nicholasrighi/3D_Printer_Board/README.md

# 3D_Printer_Board

Circuit board layout for 3D printer control board and partial 3D printer control code.
