nicholasrighi/3D_Printer_Board/Driver_board.kicad_pcb

## KiCad design Driver_board.kicad_pcb (2020-10-23)

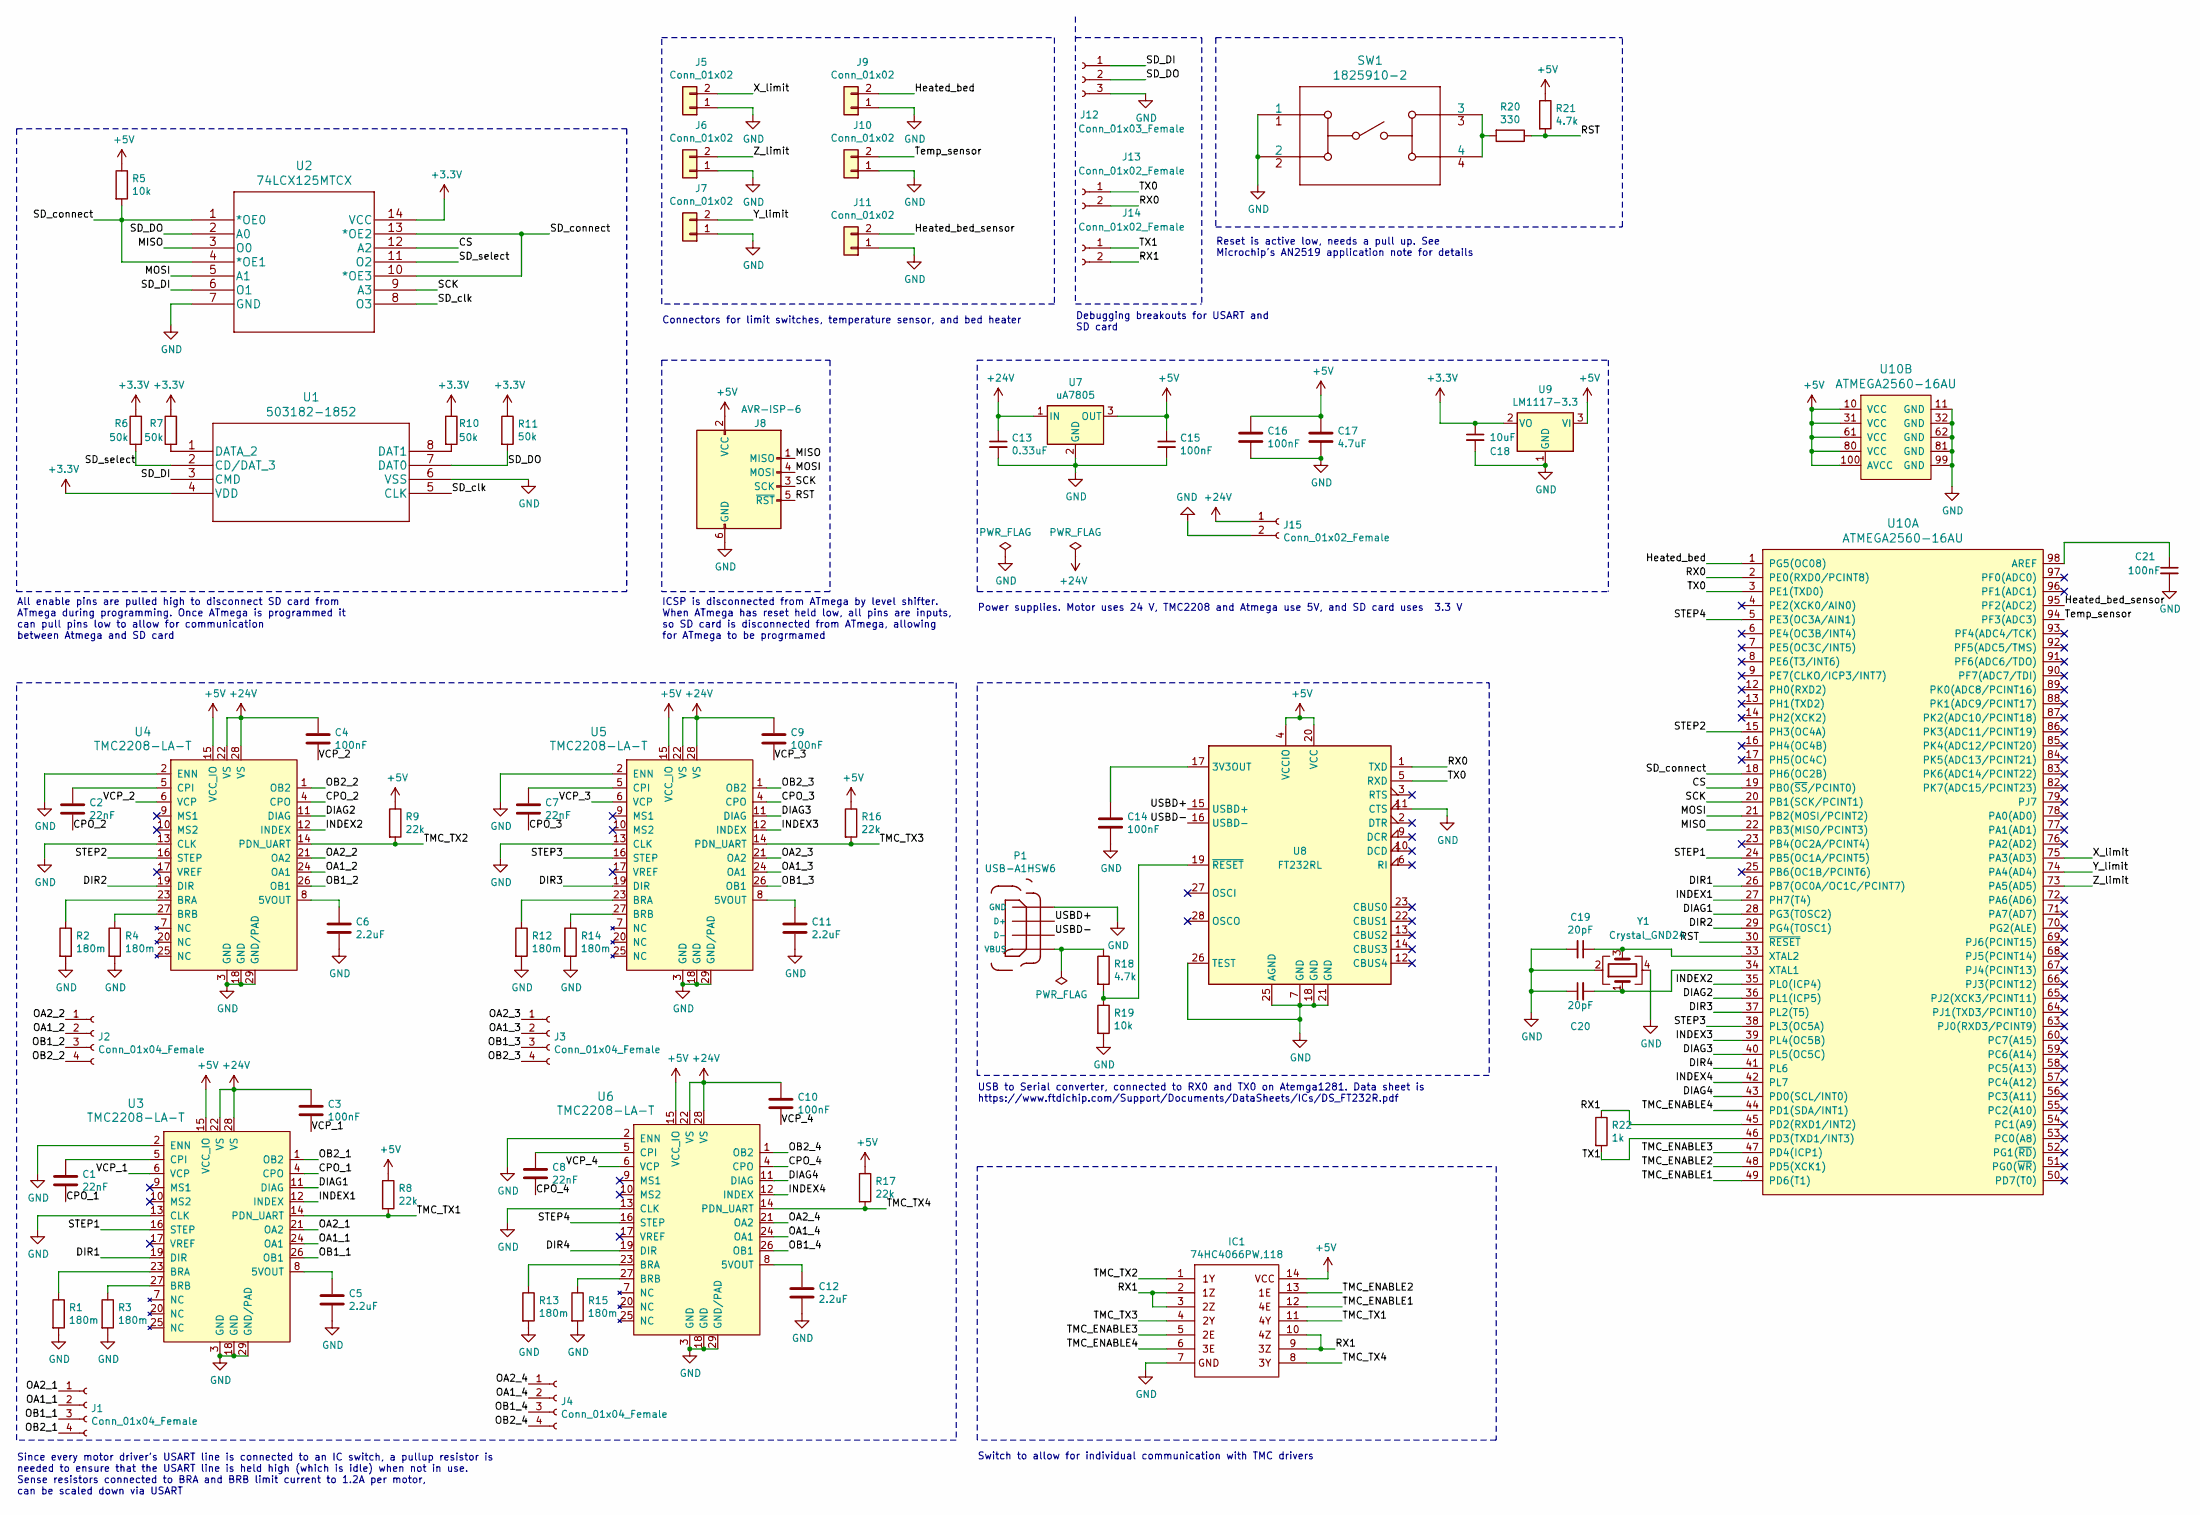
[picture p1: schematic Driver_board.sch]

Parts:
C1, C2, C7, C8: 22nF; C_0805_2012Metric_Pad1.15x1.40mm_HandSolder
C3, C4, C9, C10, C14, C21: 100nF; C_0805_2012Metric_Pad1.15x1.40mm_HandSolder
C5, C6, C11, C12: 2.2uF; C_0805_2012Metric_Pad1.15x1.40mm_HandSolder
C13: 0.33uF; alum_electro_cap
C15, C16: 100nF; alum_electro_cap
C17: 4.7uF; alum_electro_cap
C18: 10uF; alum_electro_cap
C19, C20: 20pF; C_0805_2012Metric_Pad1.15x1.40mm_HandSolder
IC1: 74HC4066PW,118; SOP65P640X110-14N; Manufacturer_Part_Number 74HC4066PW,118; Mouser Part Number 771-74HC4066PW-T
J1, J2, J3, J4: Conn_01x04_Female; PinHeader_1x04_P2.54mm_Vertical
J5, J6, J7, J9, J10, J11: Conn_01x02; PinHeader_1x02_P2.54mm_Vertical
J8: AVR-ISP-6; PinHeader_2x03_P2.54mm_Vertical
J12: Conn_01x03_Female; PinHeader_1x03_P2.54mm_Vertical
J13, J14: Conn_01x02_Female; PinSocket_1x02_P2.54mm_Vertical
J15: Conn_01x02_Female; 282837-2_power_connector
P1: USB-A1HSW6; OST_USB-A1HSW6
R1, R2, R3, R4, R12, R13, R14, R15: 180m; R_0805_2012Metric_Pad1.15x1.40mm_HandSolder
R5, R19: 10k; R_0805_2012Metric_Pad1.15x1.40mm_HandSolder
R6, R7, R10, R11: 50k; R_0805_2012Metric_Pad1.15x1.40mm_HandSolder
R8, R9, R16, R17: 22k; R_0805_2012Metric_Pad1.15x1.40mm_HandSolder
R18, R21: 4.7k; R_0805_2012Metric_Pad1.15x1.40mm_HandSolder
R20: 330; R_0805_2012Metric_Pad1.15x1.40mm_HandSolder
R22: 1k; R_0805_2012Metric_Pad1.15x1.40mm_HandSolder
SW1: 1825910-2; 1825910-2_pushbutton
U1: 503182-1852
U2: 74LCX125MTCX
U3, U4, U5, U6: TMC2208-LA-T; VFQFN-28-1EP_5x5mm; MPN TMC2208-LA-T; Digi-Key_PN 1460-1184-1-ND
U7: uA7805; UA7805CKTTR
U8: FT232RL; SSOP-28_5.3x10.2mm_P0.65mm
U9: LM1117-3.3; LM1117IMP-3.3&slash_NOPB
U10: ATMEGA2560-16AU; TQFP-100_14x14mm; MPN ATMEGA2560-16AU; Digi-Key_PN ATMEGA2560-16AU-ND
Y1: Crystal_GND24; Crystal_SMD_3225-4Pin_3.2x2.5mm

Connections:
+3V3: C18.1, R6.1, R7.1, R10.1, R11.1, U1.4 (VDD), U2.14 (VCC), U9.2 (VO)
+5V: C15.1, C16.1, C17.1, IC1.14, J8.2 (VCC), R5.1, R8.1, R9.1, R16.1, R17.1, R21.1, U3.15 (VCC_IO), U4.15 (VCC_IO), U5.15 (VCC_IO), U6.15 (VCC_IO), U7.3 (OUT), U8.4 (VCCIO), U8.20 (VCC), U9.3 (VI), U10.10 (VCC), U10.31 (VCC), U10.61 (VCC), U10.80 (VCC), U10.100 (AVCC)
+24V: C3.1, C4.1, C9.1, C10.1, C13.1, J15.1, U3.22 (VS), U3.28 (VS), U4.22 (VS), U4.28 (VS), U5.22 (VS), U5.28 (VS), U6.22 (VS), U6.28 (VS), U7.1 (IN)
/CPO_1: C1.2, U3.4 (CPO)
/CPO_2: C2.2, U4.4 (CPO)
/CPO_3: C7.2, U5.4 (CPO)
/CPO_4: C8.2, U6.4 (CPO)
/CS: U2.12 (A2), U10.19 (PB0(~SS~/PCINT0))
/DIAG1: U3.11 (DIAG), U10.28 (PG3(TOSC2))
/DIAG2: U4.11 (DIAG), U10.36 (PL1(ICP5))
/DIAG3: U5.11 (DIAG), U10.40 (PL5(OC5C))
/DIAG4: U6.11 (DIAG), U10.43 (PD0(SCL/INT0))
/DIR1: U3.19 (DIR), U10.26 (PB7(OC0A/OC1C/PCINT7))
/DIR2: U4.19 (DIR), U10.29 (PG4(TOSC1))
/DIR3: U5.19 (DIR), U10.37 (PL2(T5))
/DIR4: U6.19 (DIR), U10.41 (PL6)
/Heated_bed: J9.2, U10.1 (PG5(OC08))
/Heated_bed_sensor: J11.2, U10.95 (PF2(ADC2))
/INDEX1: U3.12 (INDEX), U10.27 (PH7(T4))
/INDEX2: U4.12 (INDEX), U10.35 (PL0(ICP4))
/INDEX3: U5.12 (INDEX), U10.39 (PL4(OC5B))
/INDEX4: U6.12 (INDEX), U10.42 (PL7)
/MISO: J8.1 (MISO), U2.3 (O0), U10.22 (PB3(MISO/PCINT3))
/MOSI: J8.4 (MOSI), U2.5 (A1), U10.21 (PB2(MOSI/PCINT2))
/OA1_1: J1.2, U3.24 (OA1)
/OA1_2: J2.2, U4.24 (OA1)
/OA1_3: J3.2, U5.24 (OA1)
/OA1_4: J4.2, U6.24 (OA1)
/OA2_1: J1.1, U3.21 (OA2)
/OA2_2: J2.1, U4.21 (OA2)
/OA2_3: J3.1, U5.21 (OA2)
/OA2_4: J4.1, U6.21 (OA2)
/OB1_1: J1.3, U3.26 (OB1)
/OB1_2: J2.3, U4.26 (OB1)
/OB1_3: J3.3, U5.26 (OB1)
/OB1_4: J4.3, U6.26 (OB1)
/OB2_1: J1.4, U3.1 (OB2)
/OB2_2: J2.4, U4.1 (OB2)
/OB2_3: J3.4, U5.1 (OB2)
/OB2_4: J4.4, U6.1 (OB2)
/RST: J8.5 (~RST), R20.1, R21.2, U10.30 (~RESET)
/RX0: J13.2, U8.1 (TXD), U10.2 (PE0(RXD0/PCINT8))
/RX1: IC1.2, IC1.3, IC1.9, IC1.10, J14.2, R22.1, U10.45 (PD2(RXD1/INT2))
/SCK: J8.3 (SCK), U2.9 (A3), U10.20 (PB1(SCK/PCINT1))
/SD_DI: J12.1, U1.3 (CMD), U2.6 (O1)
/SD_DO: J12.2, R11.2, U1.7 (DAT0), U2.2 (A0)
/SD_clk: U1.5 (CLK), U2.8 (O3)
/SD_connect: R5.2, U2.1 (*OE0), U2.4 (*OE1), U2.10 (*OE3), U2.13 (*OE2), U10.18 (PH6(OC2B))
/SD_select: R6.2, U1.2 (CD/DAT_3), U2.11 (O2)
/STEP1: U3.16 (STEP), U10.24 (PB5(OC1A/PCINT5))
/STEP2: U4.16 (STEP), U10.15 (PH3(OC4A))
/STEP3: U5.16 (STEP), U10.38 (PL3(OC5A))
/STEP4: U6.16 (STEP), U10.5 (PE3(OC3A/AIN1))
/TMC_ENABLE1: IC1.12, U10.49 (PD6(T1))
/TMC_ENABLE2: IC1.13, U10.48 (PD5(XCK1))
/TMC_ENABLE3: IC1.5, U10.47 (PD4(ICP1))
/TMC_ENABLE4: IC1.6, U10.44 (PD1(SDA/INT1))
/TMC_TX1: IC1.11, R8.2, U3.14 (PDN_UART)
/TMC_TX2: IC1.1, R9.2, U4.14 (PDN_UART)
/TMC_TX3: IC1.4, R16.2, U5.14 (PDN_UART)
/TMC_TX4: IC1.8, R17.2, U6.14 (PDN_UART)
/TX0: J13.1, U8.5 (RXD), U10.3 (PE1(TXD0))
/TX1: J14.1, R22.2, U10.46 (PD3(TXD1/INT3))
/Temp_sensor: J10.2, U10.94 (PF3(ADC3))
/USBD+: P1.3 (D+), U8.15 (USBD+)
/USBD-: P1.2 (D-), U8.16 (USBD-)
/VCP_1: C3.2, U3.6 (VCP)
/VCP_2: C4.2, U4.6 (VCP)
/VCP_3: C9.2, U5.6 (VCP)
/VCP_4: C10.2, U6.6 (VCP)
/X_limit: J5.2, U10.75 (PA3(AD3))
/Y_limit: J7.2, U10.74 (PA4(AD4))
/Z_limit: J6.2, U10.73 (PA5(AD5))
GND: C5.2, C6.2, C11.2, C12.2, C13.2, C14.2, C15.2, C16.2, C17.2, C18.2, C19.2, C20.1, C21.2, IC1.7, J5.1, J6.1, J7.1, J8.6 (GND), J9.1, J10.1, J11.1, J12.3, J15.2, P1.4 (GND), R1.2, R2.2, R3.2, R4.2, R12.2, R13.2, R14.2, R15.2, R19.2, SW1.1, SW1.2, U1.6 (VSS), U2.7 (GND), U3.2 (ENN), U3.3 (GND), U3.13 (CLK), U3.18 (GND), U3.29 (GND/PAD), U4.2 (ENN), U4.3 (GND), U4.13 (CLK), U4.18 (GND), U4.29 (GND/PAD), U5.2 (ENN), U5.3 (GND), U5.13 (CLK), U5.18 (GND), U5.29 (GND/PAD), U6.2 (ENN), U6.3 (GND), U6.13 (CLK), U6.18 (GND), U6.29 (GND/PAD), U7.2 (GND), U8.7 (GND), U8.11 (CTS), U8.18 (GND), U8.21 (GND), U8.25 (AGND), U8.26 (TEST), U9.1 (GND), U10.11 (GND), U10.32 (GND), U10.62 (GND), U10.81 (GND), U10.99 (GND), Y1.2, Y1.4
unnamed: C1.1, U3.5 (CPI)
unnamed: C2.1, U4.5 (CPI)
unnamed: C5.1, U3.8 (5VOUT)
unnamed: C6.1, U4.8 (5VOUT)
unnamed: C7.1, U5.5 (CPI)
unnamed: C8.1, U6.5 (CPI)
unnamed: C11.1, U5.8 (5VOUT)
unnamed: C12.1, U6.8 (5VOUT)
unnamed: C14.1, U8.17 (3V3OUT)
unnamed: C19.1, U10.33 (XTAL2), Y1.3
unnamed: C20.2, U10.34 (XTAL1), Y1.1
unnamed: C21.1, U10.98 (AREF)
unnamed: P1.1 (VBUS), R18.1
unnamed: R1.1, U3.23 (BRA)
unnamed: R2.1, U4.23 (BRA)
unnamed: R3.1, U3.27 (BRB)
unnamed: R4.1, U4.27 (BRB)
unnamed: R7.2, U1.1 (DATA_2)
unnamed: R10.2, U1.8 (DAT1)
unnamed: R12.1, U5.23 (BRA)
unnamed: R13.1, U6.23 (BRA)
unnamed: R14.1, U5.27 (BRB)
unnamed: R15.1, U6.27 (BRB)
unnamed: R18.2, R19.1, U8.19 (~RESET~)
unnamed: R20.2, SW1.3, SW1.4

Notes on the sheet:
Since every motor driver's USART line is connected to an IC switch, a pullup resistor is needed to ensure that the USART line is held high (which is idle) when not in use. Sense resistors connected to BRA and BRB limit current to 1.2A per motor, can be scaled down via USART
All enable pins are pulled high to disconnect SD card from ATmega during programming. Once ATmega is programmed it can pull pins low to allow for communication between Atmega and SD card
Connectors for limit switches, temperature sensor, and bed heater
Power supplies. Motor uses 24 V, TMC2208 and Atmega use 5V, and SD card uses 3.3 V
Debugging breakouts for USART and SD card
Reset is active low, needs a pull up. See Microchip's AN2519 application note for details
ICSP is disconnected from ATmega by level shifter. When ATmega has reset held low, all pins are inputs, so SD card is disconnected from ATmega, allowing for ATmega to be progrmamed
USB to Serial converter, connected to RX0 and TX0 on Atemga1281. Data sheet is https://www.ftdichip.com/Support/Documents/DataSheets/ICs/DS_FT232R.pdf
Switch to allow for individual communication with TMC drivers

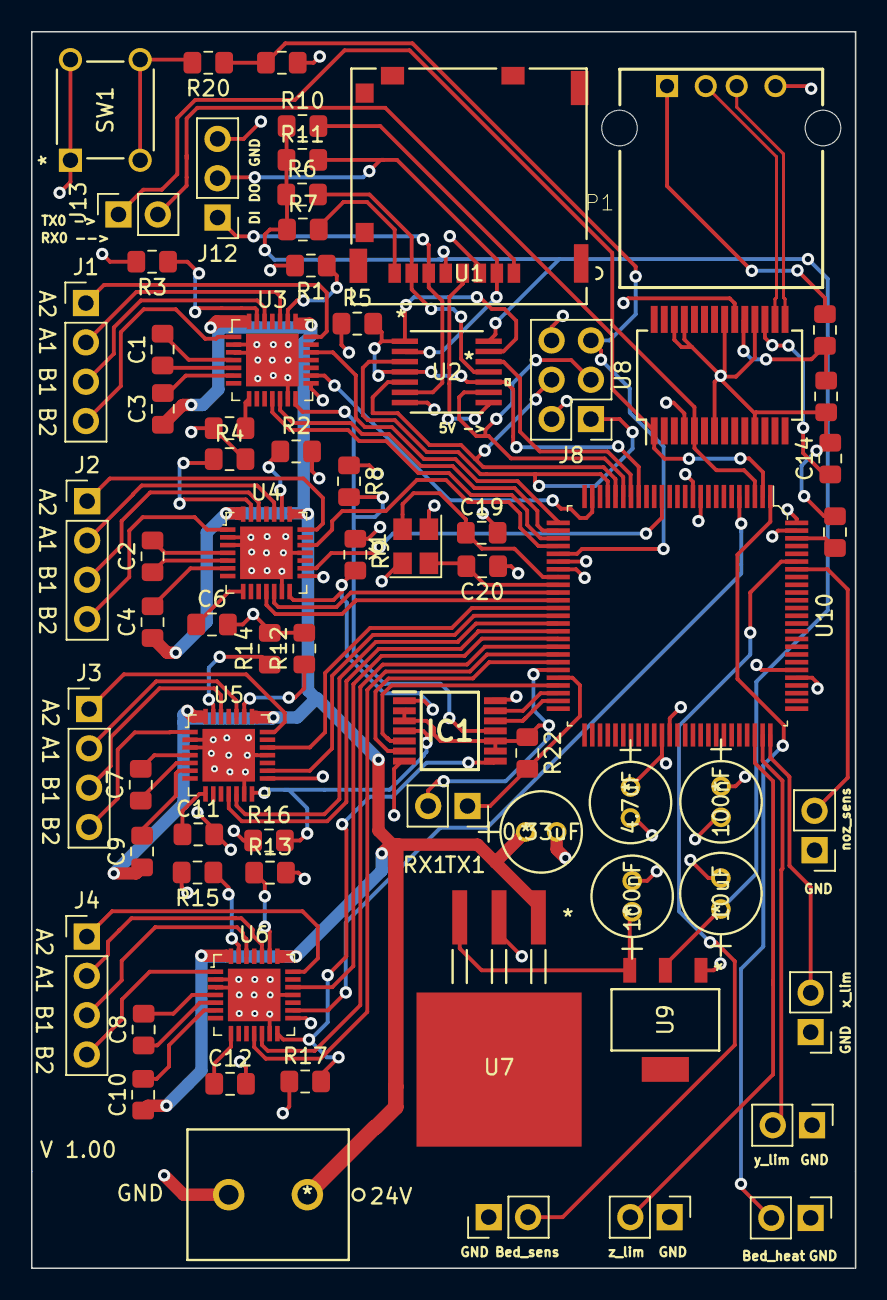
[picture p2: board Driver_board.kicad_pcb from above]

Board: 4 copper layers, 53.2 x 79.8 mm, 72 parts (0 on the bottom side), 99 nets.
